alangecker/yacharger/hw/charger2.kicad_pcb

## KiCad design hw/charger2.kicad_pcb (2021-09-03)

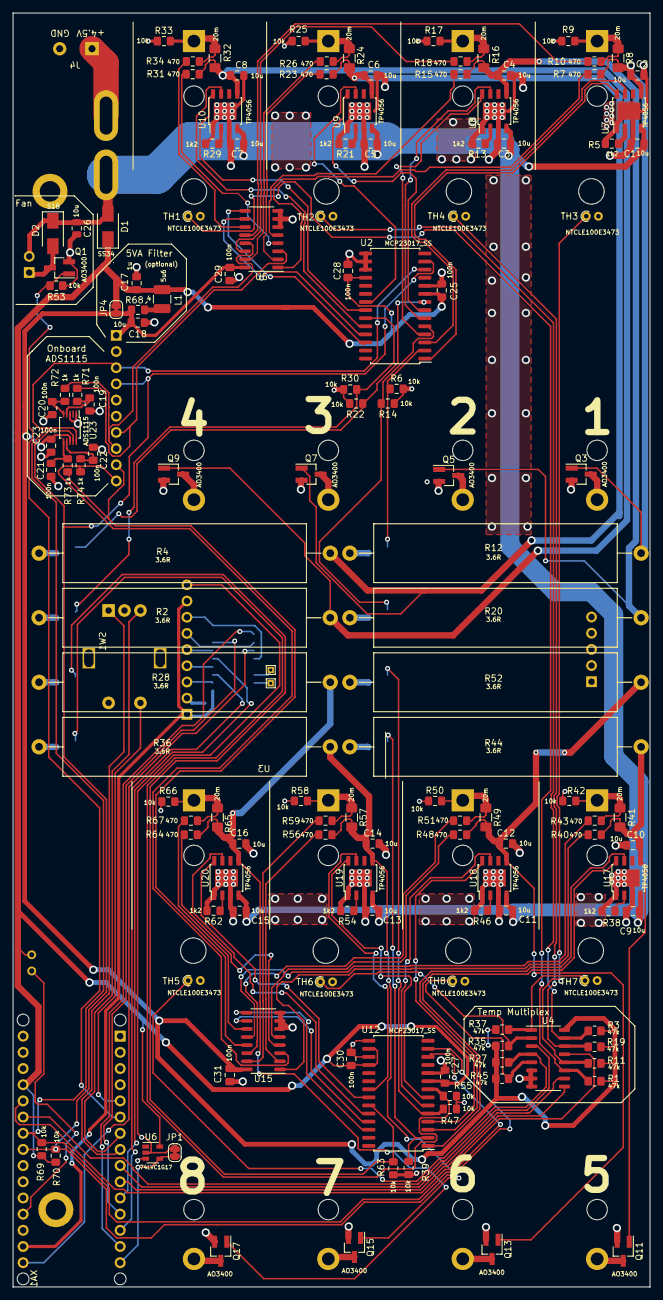
[picture p1: board charger2.kicad_pcb from above]

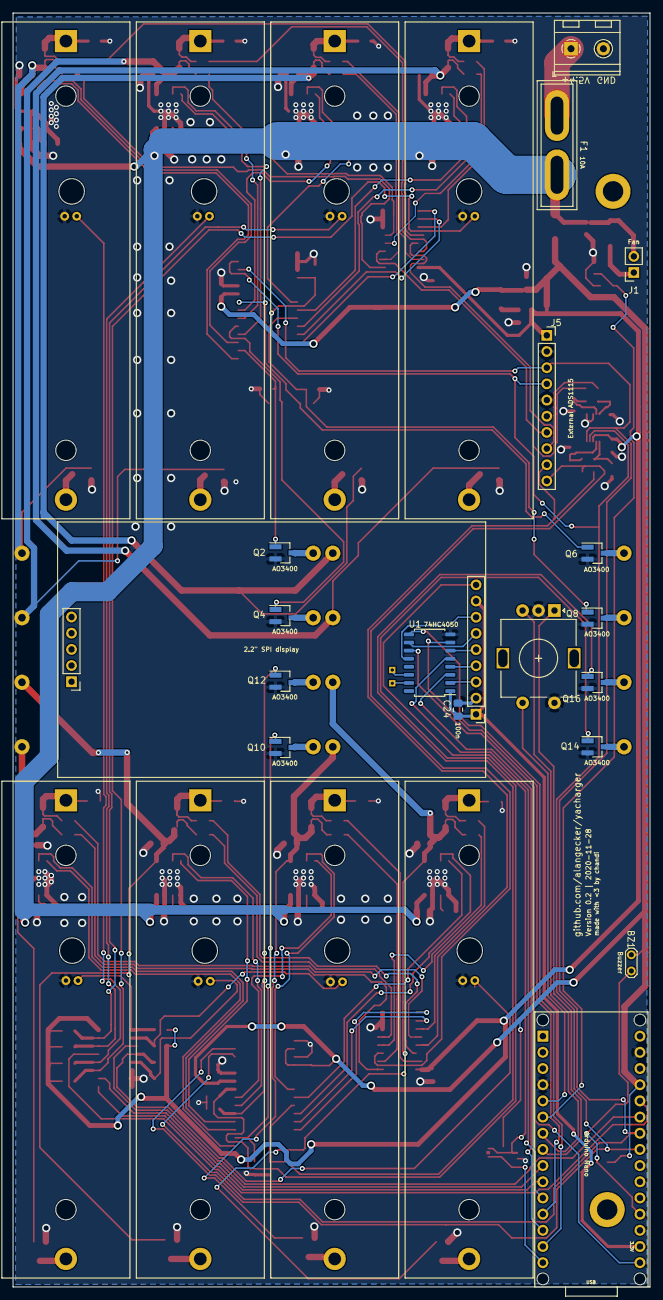
[picture p2: board charger2.kicad_pcb from below]

Board: 2 copper layers, 100.0 x 200.0 mm, 169 parts (26 on the bottom side), 133 nets.

Parts:
BT1, BT2, BT3, BT4, BT5, BT6, BT7, BT8: Battery_Cell; BatteryHolder_MPD_BH-18650-PC2
BZ1: Buzzer; TestPoint_2Pads_Pitch2.54mm_Drill0.8mm
C1, C2, C3, C4, C5, C6, C7, C8, C9, C10, C11, C12, C13, C14, C15, C16, C18: 10u; C_0805_2012Metric_Pad1.15x1.40mm_HandSolder
C17: 1u; C_0805_2012Metric_Pad1.15x1.40mm_HandSolder
C19, C20, C21, C22, C23, C24, C25, C27: 100n; C_0805_2012Metric_Pad1.15x1.40mm_HandSolder
C26: 10u; C_0805_2012Metric
C28, C29, C30, C31: 100n; C_0805_2012Metric_Pad1.18x1.45mm_HandSolder
D1: SS34; D_SMA
D2: S1B; D_SMA
F1: 10A; Fuse_Blade_ATO_directSolder
H1, H2: MountingHole; MountingHole_3.2mm_M3_ISO14580_Pad
J1: Fan; PinSocket_1x02_P2.54mm_Vertical
J4: 4.5V Power Supply; TerminalBlock_RND_205-00232_1x02_P5.08mm_Horizontal
J5: External ADS1115; PinSocket_1x10_P2.54mm_Vertical
JP1: MISO_JMP; SolderJumper-2_P1.3mm_Bridged_RoundedPad1.0x1.5mm
JP4: 5VA Bridge; SolderJumper-2_P1.3mm_Bridged_RoundedPad1.0x1.5mm
L1: 5u6; L_1210_3225Metric_Pad1.42x2.65mm_HandSolder
Q1, Q2, Q3, Q4, Q5, Q6, Q7, Q8, Q9, Q10, Q11, Q12, Q13, Q14, Q15, Q16, Q17: AO3400; SOT-23_Handsoldering
R1, R3, R11, R19, R27, R35, R37, R45: 47k; R_0805_2012Metric_Pad1.20x1.40mm_HandSolder
R2, R4, R12, R20, R28, R36, R44, R52: 3.6R; R_Axial_Power_L38.0mm_W9.0mm_P45.72mm
R5, R13, R21, R29, R38, R46, R54, R62: 1k2; R_0805_2012Metric_Pad1.15x1.40mm_HandSolder
R6, R9, R14, R17, R22, R25, R30, R33, R39, R42, R47, R50, R55, R58, R63, R66, R69, R70: 10k; R_0805_2012Metric_Pad1.15x1.40mm_HandSolder
R7, R10, R15, R18, R23, R26, R31, R34, R40, R43, R48, R51, R56, R59, R64, R67: 470; R_0805_2012Metric_Pad1.15x1.40mm_HandSolder
R8, R16, R24, R32, R41, R49, R57, R65: 20m; R_1206_3216Metric_Pad1.42x1.75mm_HandSolder
R53: 10k; R_0805_2012Metric_Pad1.20x1.40mm_HandSolder
R68: 4; R_0805_2012Metric_Pad1.15x1.40mm_HandSolder
R71, R72, R73, R74: 1k; R_0805_2012Metric_Pad1.15x1.40mm_HandSolder
SW1: Button; RotaryEncoder_Alps_EC11E-Switch_Vertical_H20mm
TH1, TH2, TH3, TH4, TH5, TH6, TH7, TH8: NTCLE100E3473; R_Axial_DIN0204_L3.6mm_D1.6mm_P1.90mm_Vertical
TP1, TP2: TestPoint; TestPoint_THTPad_1.0x1.0mm_Drill0.5mm
U1: 74HC4050; SOP-16_4.55x10.3mm_P1.27mm
U2, U12: MCP23017_SS; SOIC-28W_7.5x17.9mm_P1.27mm
U3: 2.2" SPI display; MSP2202_2.2inch_SPI
U4, U5, U15: 74HC4052; SO-16_3.9x9.9mm_P1.27mm
U6: 74LVC1G17; SOT-23-5
U7, U8, U9, U10, U17, U18, U19, U20: TP4056; TP4056_SOP-8-PP
U23: ADS1115; TSSOP-10_3x3mm_P0.5mm
XA1: Arduino Nano; Arduino_Nano_Socket

Connections:
+3V3: C24.1, U1.1, U3.1, U3.8, XA1.3V3
+5V: BZ1.1, C17.1, C25.1, C27.1, C28.1, C30.1, D1.1, JP4.1, L1.2, R69.2, R70.2, U2.9, U2.18, U6.5, U12.9, U12.16, U12.18, XA1.5V
+5VA: C18.1, C23.1, C29.1, C31.1, J5.1, JP4.2, R1.1, R3.1, R11.1, R19.1, R27.1, R35.1, R37.1, R45.1, R68.1, U4.16, U5.16, U15.16, U23.8
/CS: U1.3, XA1.D10
/DC: U1.7, XA1.D9
/Display/3.3_CS: U1.2, U3.3
/Display/3.3_MOSI: U1.10, U3.6
/Display/3.3_RESET: U1.4, U3.4
/Display/3.3_RS: U1.6, U3.5
/Display/3.3_SCK: U1.12, U3.7
/Display/MISO: JP1.1, U6.4, XA1.D12
/Display/MOSI: U1.9, XA1.D11
/Display/SCK: U1.11, XA1.D13
/FAN_Control/FAN_PWM: Q1.1, R53.1, XA1.D3
/MCU/A6: U4.3, XA1.A6
/MCU/A7: U4.13, XA1.A7
/MCU/BUTTON: SW1.S1, XA1.D2
/MCU/BUZZER: BZ1.2, XA1.A0
/MCU/ROT_A: SW1.A, XA1.D5
/MCU/ROT_B: SW1.B, XA1.D4
/MCU/SDA: J5.4, R70.1, U2.13, U12.13, U23.9, XA1.A4
/RST: U1.5, XA1.D8
/TempMultiplex/S_A: U4.10, XA1.D6
/TempMultiplex/S_B: U4.9, XA1.D7
/TempMultiplex/T1: R11.2, TH3.1, U4.12
/TempMultiplex/T2: R19.2, TH4.1, U4.14
/TempMultiplex/T3: R3.2, TH2.1, U4.15
/TempMultiplex/T4: R1.2, TH1.1, U4.11
/adc/AIN0: J5.7, R71.2, U5.3
/adc/AIN1: J5.8, R72.2, U5.13
/adc/AIN2: J5.9, R73.2, U15.13
/adc/AIN3: J5.10, R74.2, U15.3
/quadcharger1/Battery/Bat+: BT1.1, R8.1, R9.1, R10.2
/quadcharger1/Battery/Bat+': C2.1, Q3.1, R7.1, R8.2, R12.1, U7.5
/quadcharger1/Battery/Bat-: BT1.2, Q3.3
/quadcharger1/Battery/CE: U2.1, U7.8
/quadcharger1/Battery/CHRG: U2.3, U7.7
/quadcharger1/Battery/DE: Q2.1, R6.1, U2.2
/quadcharger1/SCK: J5.3, R69.1, U2.12, U12.12, U23.10, XA1.A5
/quadcharger1/X0: R10.1, U5.12
/quadcharger1/X1: R18.1, U5.14
/quadcharger1/X2: R26.1, U5.15
/quadcharger1/X3: R34.1, U5.11
/quadcharger1/Y0: R7.2, U5.1
/quadcharger1/Y1: R15.2, U5.5
/quadcharger1/Y2: R23.2, U5.2
/quadcharger1/Y3: R31.2, U5.4
/quadcharger1/sheet5DC5D9EA/Bat+: BT3.1, R24.1, R25.1, R26.2
/quadcharger1/sheet5DC5D9EA/Bat+': C6.1, Q7.1, R4.1, R23.1, R24.2, U9.5
/quadcharger1/sheet5DC5D9EA/Bat-: BT3.2, Q7.3
/quadcharger1/sheet5DC5D9EA/CE: U2.7, U9.8
/quadcharger1/sheet5DC5D9EA/CHRG: U2.21, U9.7
/quadcharger1/sheet5DC5D9EA/DE: Q6.1, R22.1, U2.8
/quadcharger1/sheet5DC5D930/Bat+: BT2.1, R16.1, R17.1, R18.2
/quadcharger1/sheet5DC5D930/Bat+': C4.1, Q5.1, R15.1, R16.2, R20.1, U8.5
/quadcharger1/sheet5DC5D930/Bat-: BT2.2, Q5.3
/quadcharger1/sheet5DC5D930/CE: U2.4, U8.8
/quadcharger1/sheet5DC5D930/CHRG: U2.6, U8.7
/quadcharger1/sheet5DC5D930/DE: Q4.1, R14.1, U2.5
/quadcharger1/sheet5DC5DB5C/Bat+: BT4.1, R32.1, R33.1, R34.2
/quadcharger1/sheet5DC5DB5C/Bat+': C8.1, Q9.1, R2.1, R31.1, R32.2, U10.5
/quadcharger1/sheet5DC5DB5C/Bat-: BT4.2, Q9.3
/quadcharger1/sheet5DC5DB5C/CE: U2.22, U10.8
/quadcharger1/sheet5DC5DB5C/CHRG: U2.24, U10.7
/quadcharger1/sheet5DC5DB5C/DE: Q8.1, R30.1, U2.23
/quadcharger2/Battery/Bat+: BT5.1, R41.1, R42.1, R43.2
/quadcharger2/Battery/Bat+': C10.1, Q11.1, R40.1, R41.2, R44.1, U17.5
/quadcharger2/Battery/Bat-: BT5.2, Q11.3
/quadcharger2/Battery/CE: U12.1, U17.8
/quadcharger2/Battery/CHRG: U12.3, U17.7
/quadcharger2/Battery/DE: Q10.1, R39.1, U12.2
/quadcharger2/T1: R37.2, TH7.1, U4.1
/quadcharger2/T2: R45.2, TH8.1, U4.5
/quadcharger2/T3: R35.2, TH6.1, U4.2
/quadcharger2/T4: R27.2, TH5.1, U4.4
/quadcharger2/X0: R43.1, U15.12
/quadcharger2/X1: R51.1, U15.14
/quadcharger2/X2: R59.1, U15.15
/quadcharger2/X3: R67.1, U15.11
/quadcharger2/Y0: R40.2, U15.1
/quadcharger2/Y1: R48.2, U15.5
/quadcharger2/Y2: R56.2, U15.2
/quadcharger2/Y3: R64.2, U15.4
/quadcharger2/sheet5DC5D9EA/Bat+: BT7.1, R57.1, R58.1, R59.2
/quadcharger2/sheet5DC5D9EA/Bat+': C14.1, Q15.1, R36.1, R56.1, R57.2, U19.5
/quadcharger2/sheet5DC5D9EA/Bat-: BT7.2, Q15.3
/quadcharger2/sheet5DC5D9EA/CE: U12.7, U19.8
/quadcharger2/sheet5DC5D9EA/CHRG: U12.21, U19.7
/quadcharger2/sheet5DC5D9EA/DE: Q14.1, R55.1, U12.8
/quadcharger2/sheet5DC5D930/Bat+: BT6.1, R49.1, R50.1, R51.2
/quadcharger2/sheet5DC5D930/Bat+': C12.1, Q13.1, R48.1, R49.2, R52.1, U18.5
/quadcharger2/sheet5DC5D930/Bat-: BT6.2, Q13.3
/quadcharger2/sheet5DC5D930/CE: U12.4, U18.8
/quadcharger2/sheet5DC5D930/CHRG: U12.6, U18.7
/quadcharger2/sheet5DC5D930/DE: Q12.1, R47.1, U12.5
/quadcharger2/sheet5DC5DB5C/Bat+: BT8.1, R65.1, R66.1, R67.2
/quadcharger2/sheet5DC5DB5C/Bat+': C16.1, Q17.1, R28.1, R64.1, R65.2, U20.5
/quadcharger2/sheet5DC5DB5C/Bat-: BT8.2, Q17.3
/quadcharger2/sheet5DC5DB5C/CE: U12.22, U20.8
/quadcharger2/sheet5DC5DB5C/CHRG: U12.24, U20.7
/quadcharger2/sheet5DC5DB5C/DE: Q16.1, R63.1, U12.23
GND: C1.2, C2.2, C3.2, C4.2, C5.2, C6.2, C7.2, C8.2, C9.2, C10.2, C11.2, C12.2, C13.2, C14.2, C15.2, C16.2, C17.2, C18.2, C19.2, C20.2, C21.2, C22.2, C23.2, C24.2, C25.2, C26.2, C27.2, C28.2, C29.2, C30.2, C31.2, J4.2, J5.2, J5.5, Q1.2, Q2.2, Q3.2, Q4.2, Q5.2, Q6.2, Q7.2, Q8.2, Q9.2, Q10.2, Q11.2, Q12.2, Q13.2, Q14.2, Q15.2, Q16.2, Q17.2, R5.2, R6.2, R9.2, R13.2, R14.2, R17.2, R21.2, R22.2, R25.2, R29.2, R30.2, R33.2, R38.2, R39.2, R42.2, R46.2, R47.2, R50.2, R53.2, R54.2, R55.2, R58.2, R62.2, R63.2, R66.2, SW1.C, SW1.S2, TH1.2, TH2.2, TH3.2, TH4.2, TH5.2, TH6.2, TH7.2, TH8.2, U1.8, U2.10, U2.15, U2.16, U2.17, U3.2, U4.6, U4.7, U4.8, U5.6, U5.7, U5.8, U6.3, U7.1, U7.3, U7.9, U8.1, U8.3, U8.9, U9.1, U9.3, U9.9, U10.1, U10.3, U10.9, U12.10, U12.15, U12.17, U15.6, U15.7, U15.8, U17.1, U17.3, U17.9, U18.1, U18.3, U18.9, U19.1, U19.3, U19.9, U20.1, U20.3, U20.9, U23.1, U23.3, XA1.GND1, XA1.GND2
unnamed: C19.1, R71.1, U23.4
unnamed: C20.1, R72.1, U23.5
unnamed: C21.1, R73.1, U23.6
unnamed: C22.1, R74.1, U23.7
unnamed: D2.2, J1.1, Q1.3
unnamed: F1.2, J4.1
unnamed: JP1.2, U3.9, U6.2
unnamed: L1.1, R68.2
unnamed: Q2.3, R12.2
unnamed: Q4.3, R20.2
unnamed: Q6.3, R4.2
unnamed: Q8.3, R2.2
unnamed: Q10.3, R44.2
unnamed: Q12.3, R52.2
unnamed: Q14.3, R36.2
unnamed: Q16.3, R28.2
unnamed: R5.1, U7.2
unnamed: R13.1, U8.2
unnamed: R21.1, U9.2
unnamed: R29.1, U10.2
unnamed: R38.1, U17.2
unnamed: R46.1, U18.2
unnamed: R54.1, U19.2
unnamed: R62.1, U20.2
unnamed: TP1.1, U1.14
unnamed: TP2.1, U1.15
unnamed: U2.25, U5.10
unnamed: U2.26, U5.9
unnamed: U12.25, U15.10
unnamed: U12.26, U15.9
VDD: C1.1, C3.1, C5.1, C7.1, C9.1, C11.1, C13.1, C15.1, C26.1, D1.2, D2.1, F1.1, J1.2, U7.4, U8.4, U9.4, U10.4, U17.4, U18.4, U19.4, U20.4
