alangecker/yacharger/sw/src/adc.h

#ifndef ADC_H
#define ADC_H
#include "./gpio.h"


#include <Adafruit_ADS1X15.h>

void adc_setup();
float adc_readVoltage(uint8_t slot);
float adc_readCurrent(uint8_t slot);
int8_t adc_readTemp(uint8_t slot);
#endif
