alangecker/yacharger/(commit log)

2019-11-10 multiple changes
    [Battery.sch, charger2.kicad_pcb, display.sch, mcu.sch, power.sch, quadcharger.sch]
2020-10-24 sw:display: fault/done view, optional temp feature, small bug fixes
    [consts.h, display.cpp, gpio.cpp, slot.cpp, slot.h]
2020-11-28 hw: pcb redesign
    [Battery.sch, adc.sch, charger2.kicad_pcb, charger2.sch, display.sch, fan_control.sch, mcu.sch, power.sch]
2020-12-24 fix 4052 footprint
    [charger2.kicad_pcb, quadcharger.sch, temp.sch]
2020-12-25 additional caps, groundplane improvements, MISO 3.3->5V
    [Battery.sch, charger2.kicad_pcb, display.sch, power.sch, quadcharger.sch]
2020-12-25 DRC fixes
    [charger2.kicad_pcb]
